Arthurdw/tesla-p4-shroud/output/cfd/base_rep/cfd_funnel_zfan.png

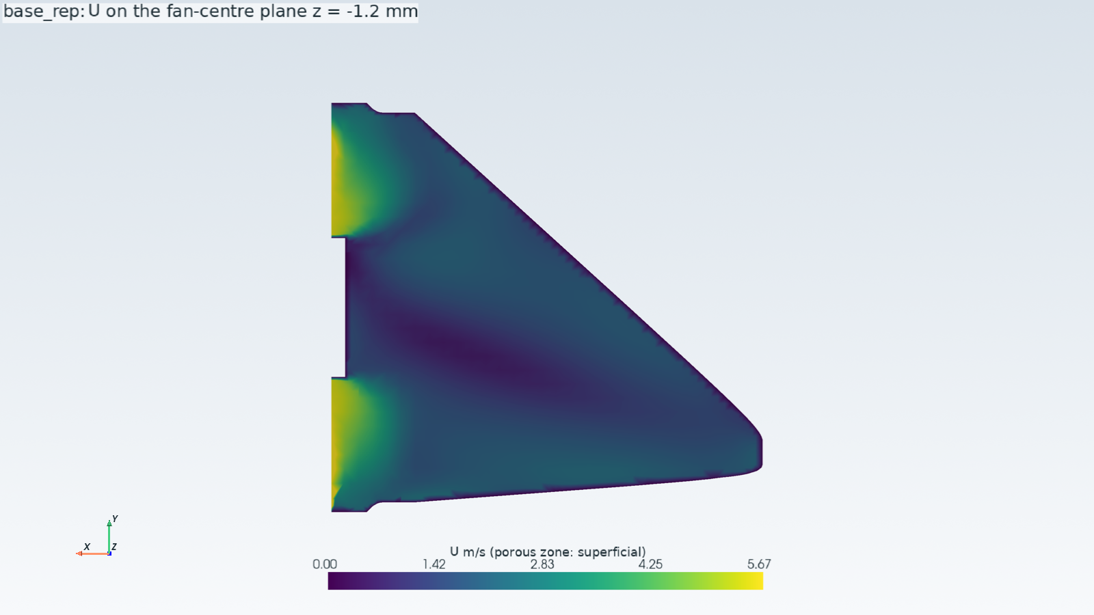
output/cfd/base_rep/cfd_funnel_zfan.png
