Arthurdw/tesla-p4-shroud/output/cfd/base_rep/cfd_plane_y.png

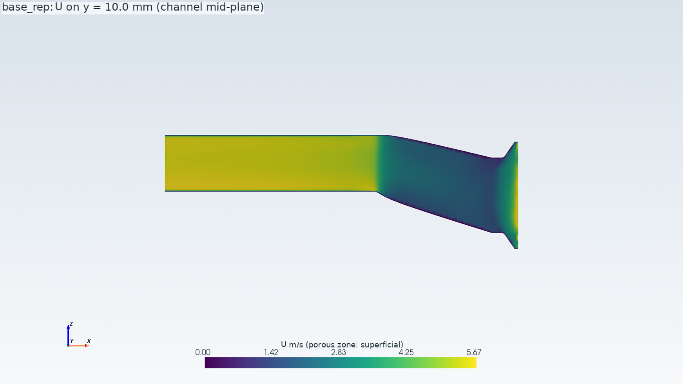
output/cfd/base_rep/cfd_plane_y.png
