Arthurdw/tesla-p4-shroud/output/cfd/final_c4/cfd_plane_y.png

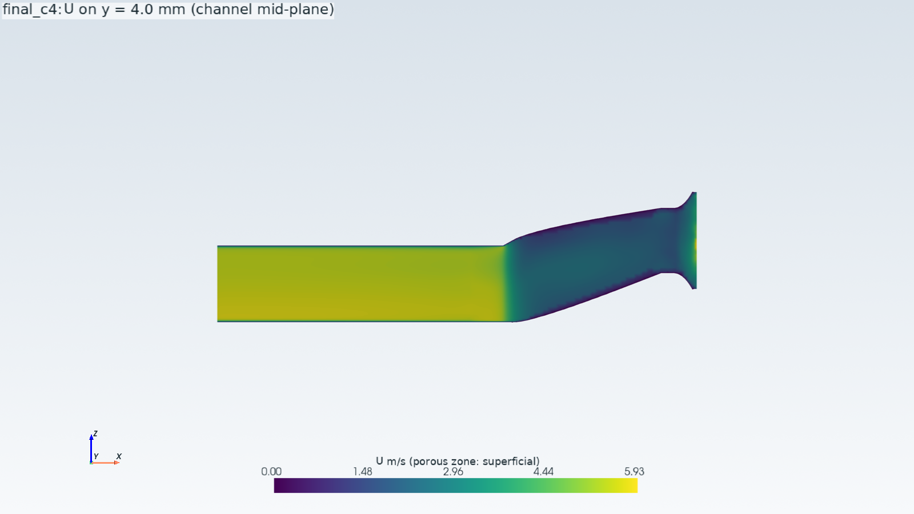
output/cfd/final_c4/cfd_plane_y.png
