Arthurdw/tesla-p4-shroud/output/cfd/hi_final_c4/cfd_funnel_zfan.png

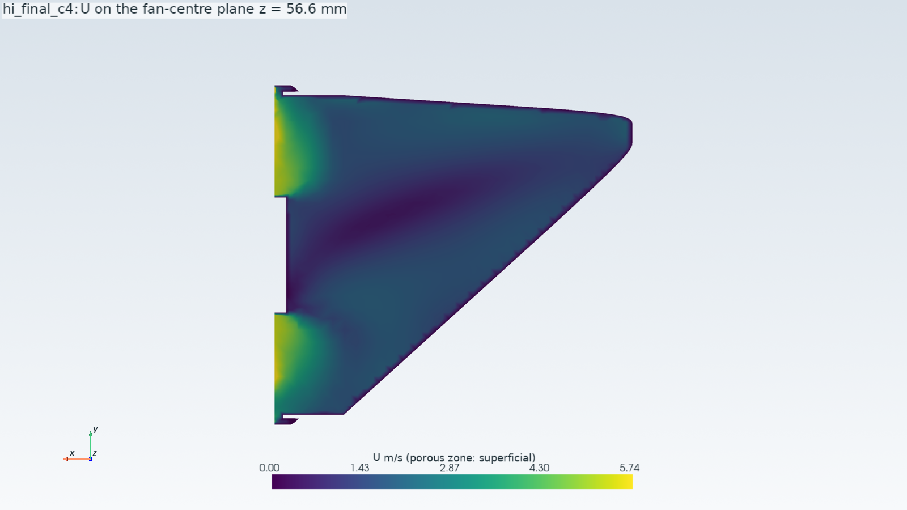
output/cfd/hi_final_c4/cfd_funnel_zfan.png
