Arthurdw/tesla-p4-shroud/output/cfd/hi_final_c4/cfd_plane_z.png

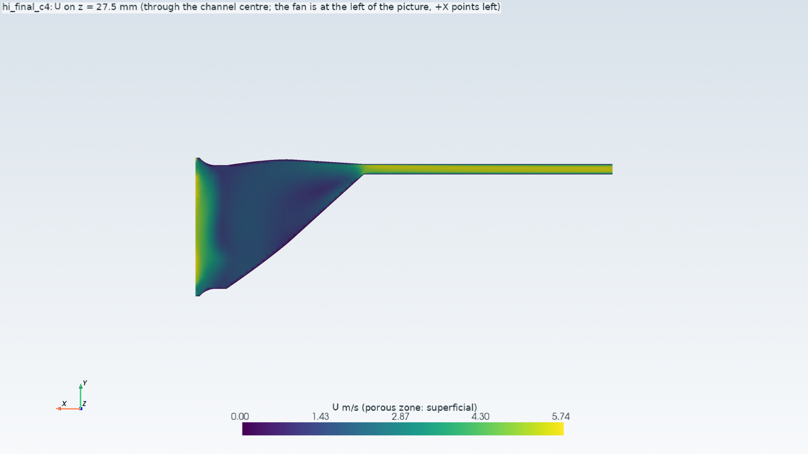
output/cfd/hi_final_c4/cfd_plane_z.png
