Arthurdw/tesla-p4-shroud/output/cfd/s_gap_2mm/cfd_pressure_x.png

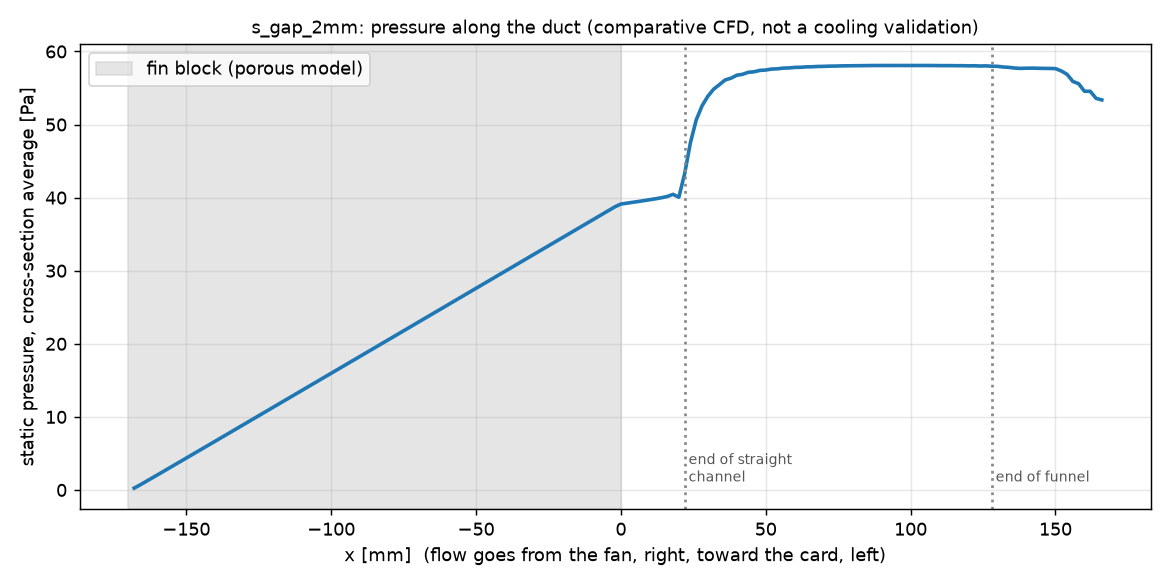
output/cfd/s_gap_2mm/cfd_pressure_x.png
