Arthurdw/tesla-p4-shroud/output/cfd/sens_diff50_c4/cfd_funnel_zfan.png

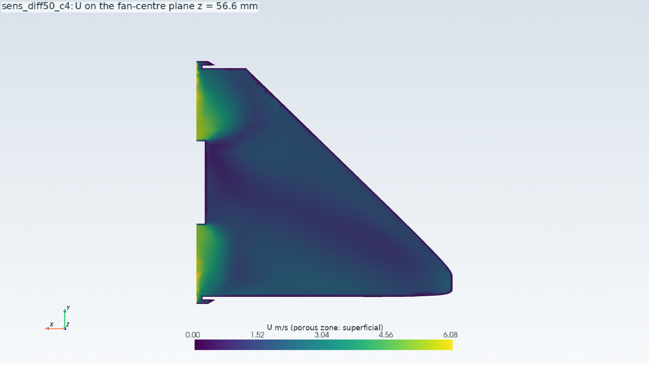
output/cfd/sens_diff50_c4/cfd_funnel_zfan.png
