Arthurdw/tesla-p4-shroud/output/cfd/sens_diff50_c4/cfd_plane_y.png

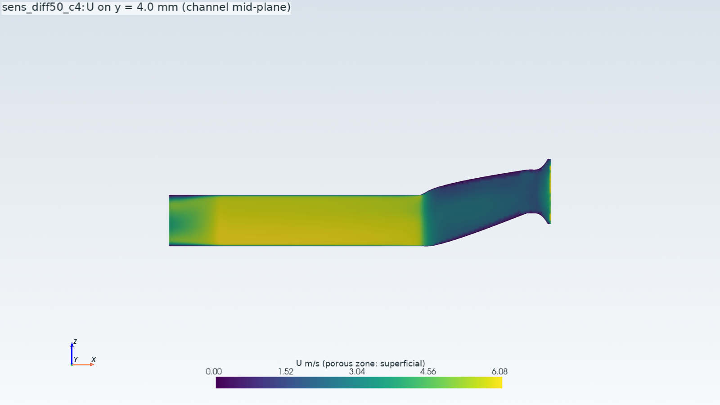
output/cfd/sens_diff50_c4/cfd_plane_y.png
