Arthurdw/tesla-p4-shroud/output/cfd/sens_diff50_c4/cfd_pressure_x.png

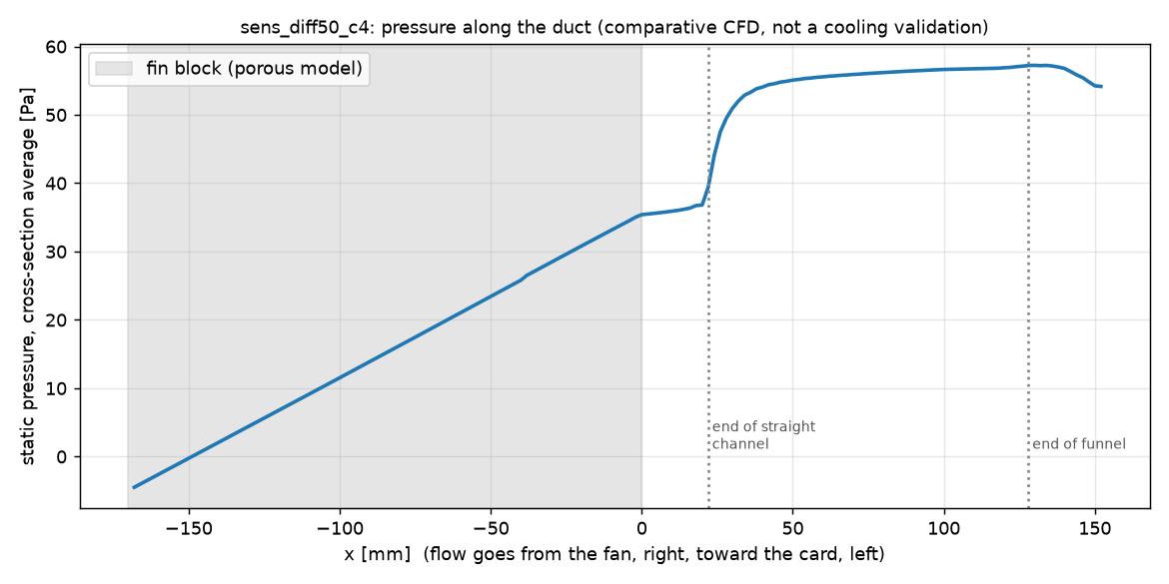
output/cfd/sens_diff50_c4/cfd_pressure_x.png
