Arthurdw/tesla-p4-shroud/output/cfd/short_t89_5k/cfd_plane_z.png

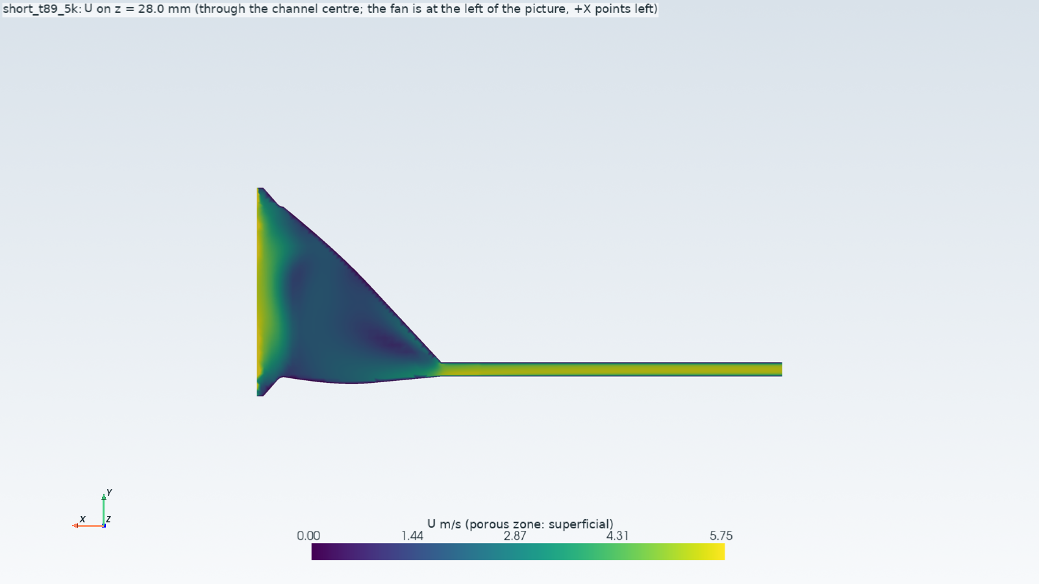
output/cfd/short_t89_5k/cfd_plane_z.png
