Arthurdw/tesla-p4-shroud/output/cfd/short_t89_5k/cfd_pressure_x.png

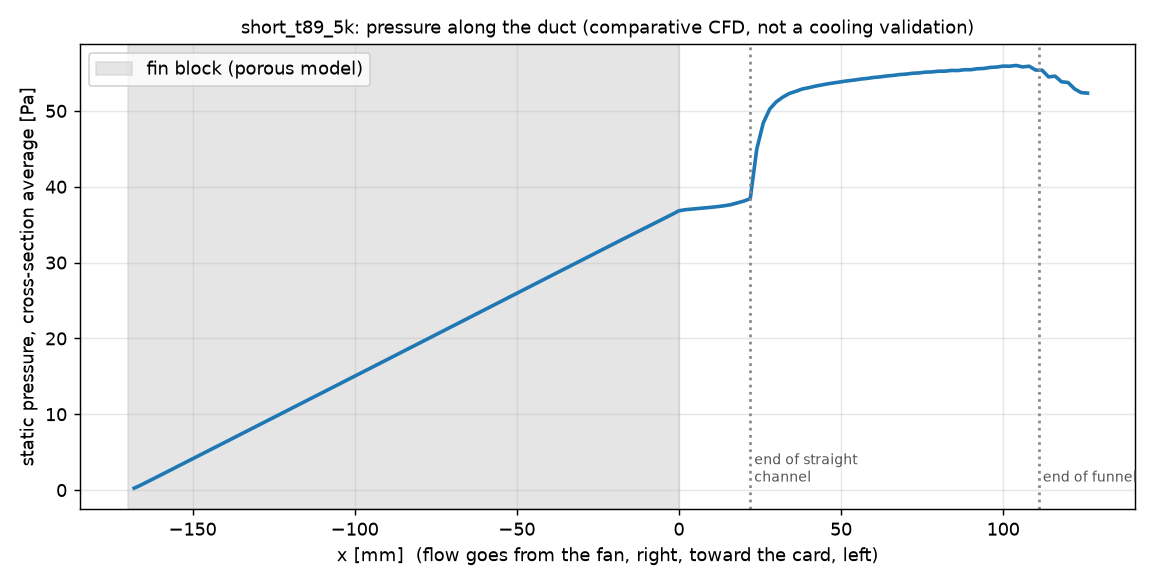
output/cfd/short_t89_5k/cfd_pressure_x.png
