Arthurdw/tesla-p4-shroud/output/cfd/spacer_t77_5k/cfd_funnel_zfan.png

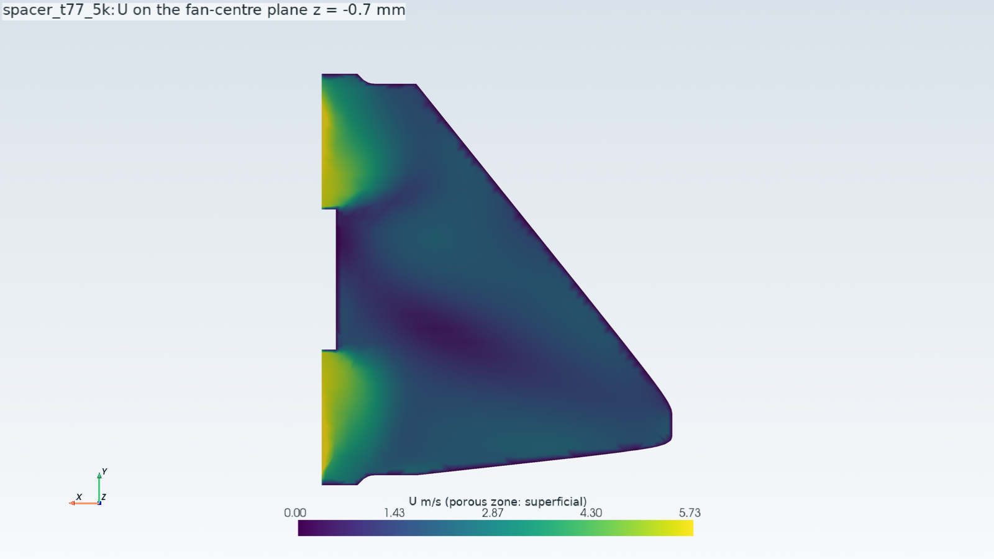
output/cfd/spacer_t77_5k/cfd_funnel_zfan.png
