Arthurdw/tesla-p4-shroud/output/preview_comb.png

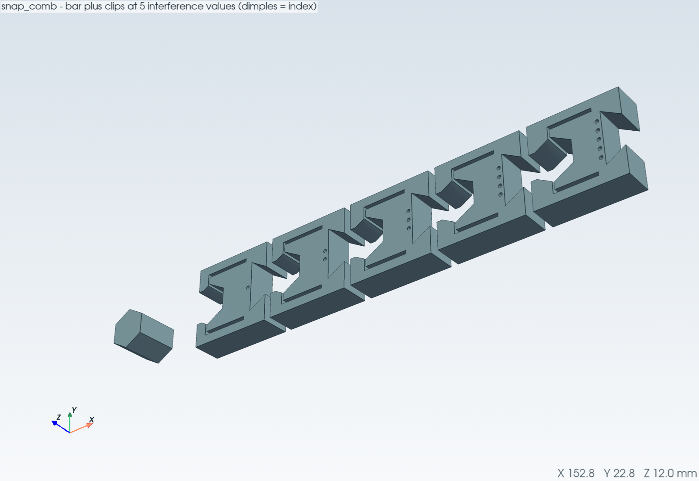
output/preview_comb.png
