Arthurdw/tesla-p4-shroud/output/preview_support_assy.png

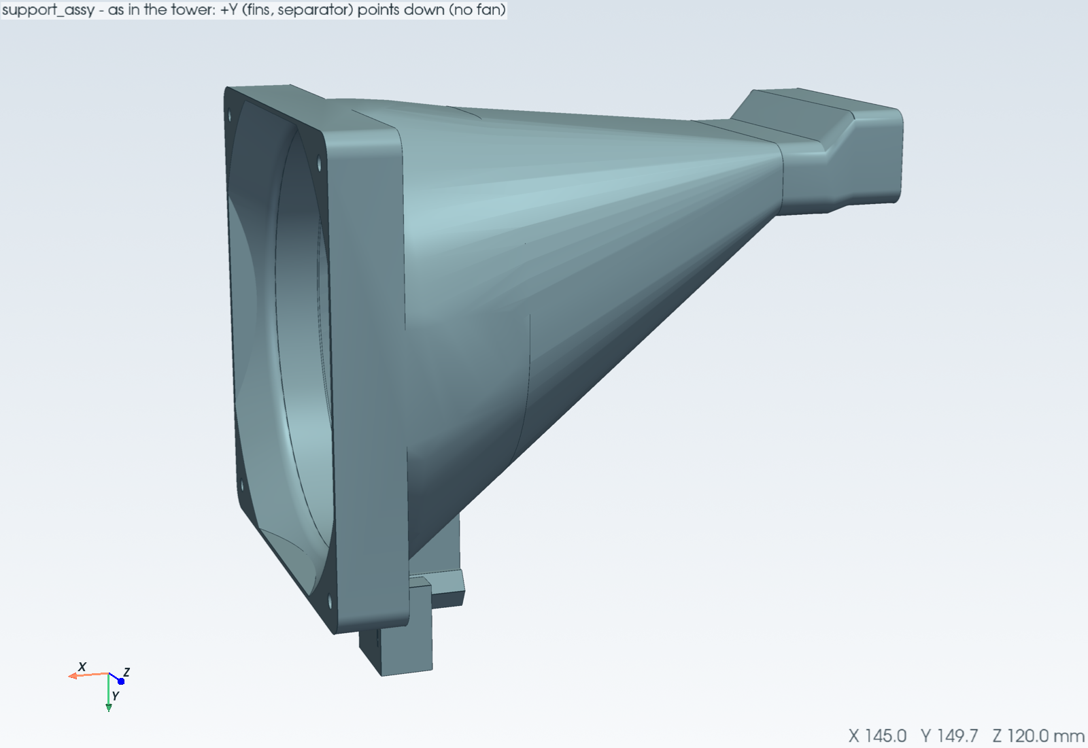
output/preview_support_assy.png
