Arthurdw/tesla-p4-shroud/output/cfd/fins/results.csv

name | t | model | u_gap | dp_total | dpdx | iters | converged | cells
t0.3_laminar_u0.4 | 0.3 | laminar | 0.4 | 1.2138539999999998 | 6.342240479999998 | 353 | True | 136488
t0.3_laminar_u3 | 0.3 | laminar | 3 | 14.415912 | 61.991958000000004 | 224 | True | 136488
t0.3_laminar_u5 | 0.3 | laminar | 5 | 29.215019999999996 | 120.6597324 | 215 | True | 136488
t0.3_laminar_u7 | 0.3 | laminar | 7 | 47.054387999999996 | 189.59086799999997 | 210 | True | 136488
t0.3_laminar_u9 | 0.3 | laminar | 9 | 67.515012 | 267.24042 | 209 | True | 136488
t0.3_kOmegaSST_u0.4 | 0.3 | kOmegaSST | 0.4 | 1.2142188 | 6.34270236 | 351 | True | 136488
t0.3_kOmegaSST_u3 | 0.3 | kOmegaSST | 3 | 13.761335999999998 | 59.867283599999986 | 226 | True | 136488
t0.3_kOmegaSST_u5 | 0.3 | kOmegaSST | 5 | 28.000812 | 120.86823599999998 | 203 | True | 136488
t0.3_kOmegaSST_u7 | 0.3 | kOmegaSST | 7 | 46.045752 | 205.98220799999999 | 196 | True | 136488
t0.3_kOmegaSST_u9 | 0.3 | kOmegaSST | 9 | 67.56991199999999 | 310.69404 | 194 | True | 136488
t0.8_laminar_u0.4 | 0.8 | laminar | 0.4 | 1.396866 | 7.4210982 | 400 | True | 142208
t0.8_laminar_u3 | 0.8 | laminar | 3 | 16.559376 | 68.8934196 | 279 | True | 142208
t0.8_laminar_u5 | 0.8 | laminar | 5 | 34.198644 | 132.665796 | 267 | True | 142208
t0.8_laminar_u7 | 0.8 | laminar | 7 | 56.090064 | 207.19656 | 254 | True | 142208
t0.8_laminar_u9 | 0.8 | laminar | 9 | 81.83809199999999 | 290.571612 | 260 | True | 142208
t0.8_kOmegaSST_u0.4 | 0.8 | kOmegaSST | 0.4 | 1.3971647999999999 | 7.4212519200000004 | 399 | True | 142208
t0.8_kOmegaSST_u3 | 0.8 | kOmegaSST | 3 | 15.608424 | 66.9587916 | 278 | True | 142208
t0.8_kOmegaSST_u5 | 0.8 | kOmegaSST | 5 | 31.756643999999998 | 134.06210399999998 | 269 | True | 142208
t0.8_kOmegaSST_u7 | 0.8 | kOmegaSST | 7 | 52.50809999999999 | 228.99971999999997 | 261 | True | 142208
t0.8_kOmegaSST_u9 | 0.8 | kOmegaSST | 9 | 77.717748 | 344.887212 | 262 | True | 142208
