Arthurdw/tesla-p4-shroud/output/preview_support_parts.png

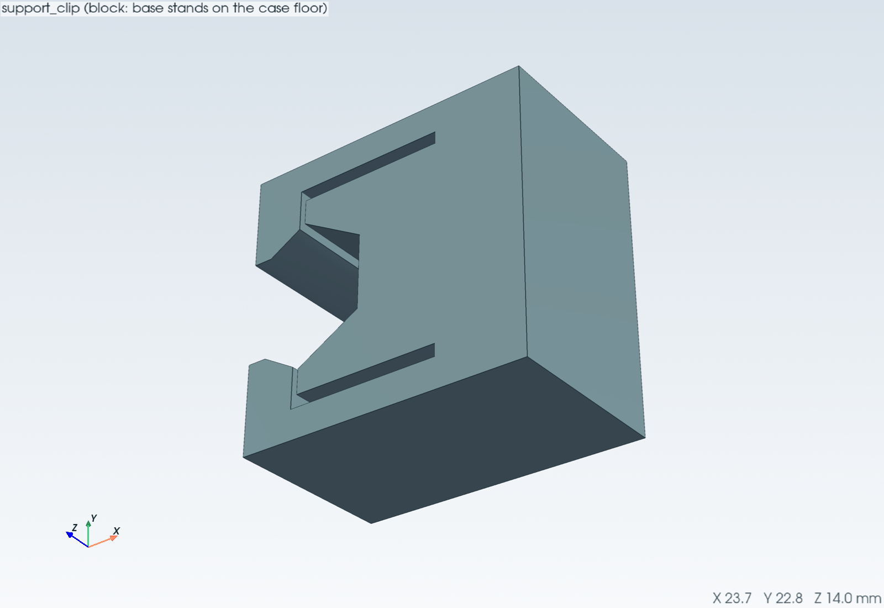
output/preview_support_parts.png
