Arthurdw/tesla-p4-shroud/output/support_assy.stl

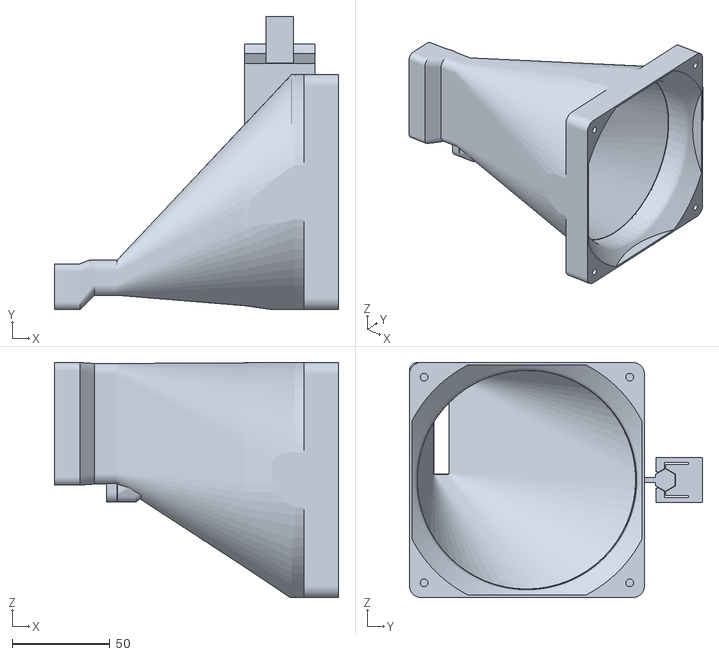
[picture p38: CAD file, 2026-10-28]
output/support_assy.stl
145.0 x 149.7 x 120.0
