Arthurdw/tesla-p4-shroud/output/spacer_print.3mf

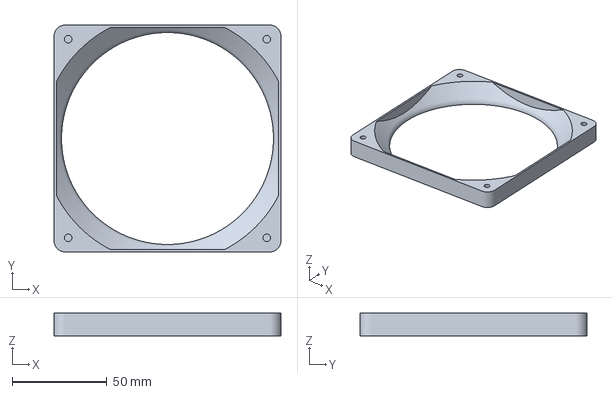
[picture p39: CAD file, 2026-10-28]
output/spacer_print.3mf
120.0 x 120.0 x 12.0 mm
