Arthurdw/tesla-p4-shroud/output/shroud_print.3mf

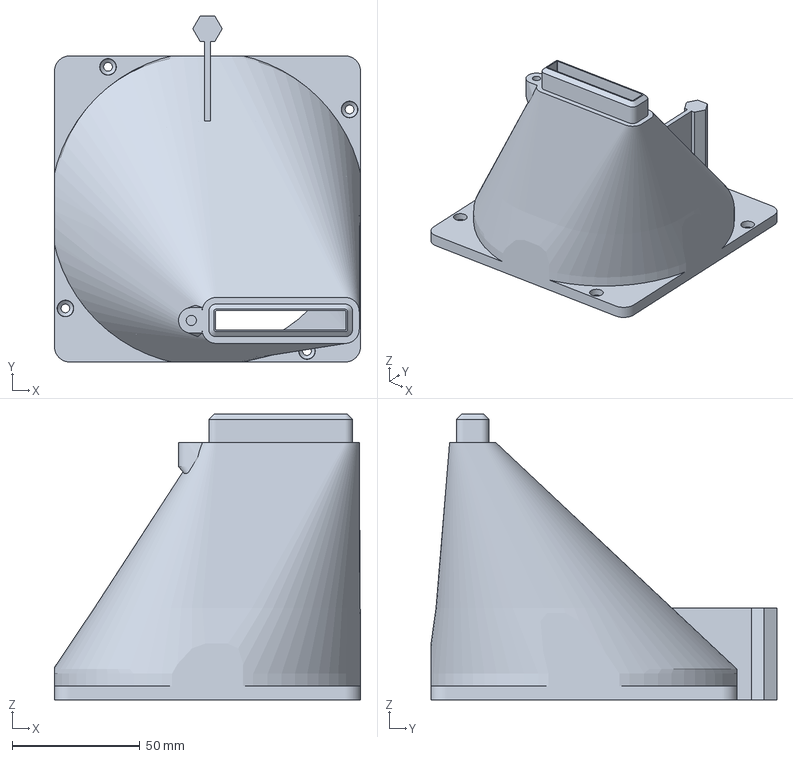
[picture p40: CAD file, 2026-10-28]
output/shroud_print.3mf
120.0 x 135.7 x 112.0 mm
