Arthurdw/tesla-p4-shroud/output/stator_layer.stl

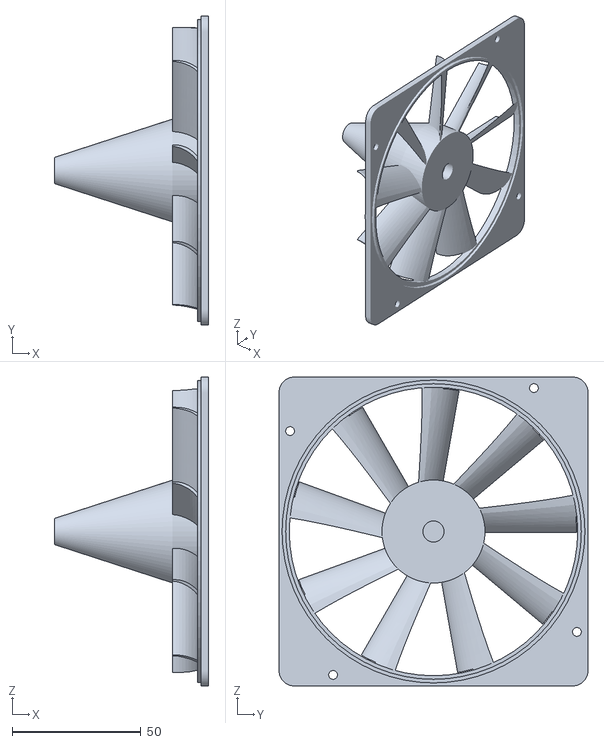
[picture p41: CAD file, 2026-10-28]
output/stator_layer.stl
60.0 x 120.0 x 120.0
