Arthurdw/tesla-p4-shroud/output/sleeve_print.3mf

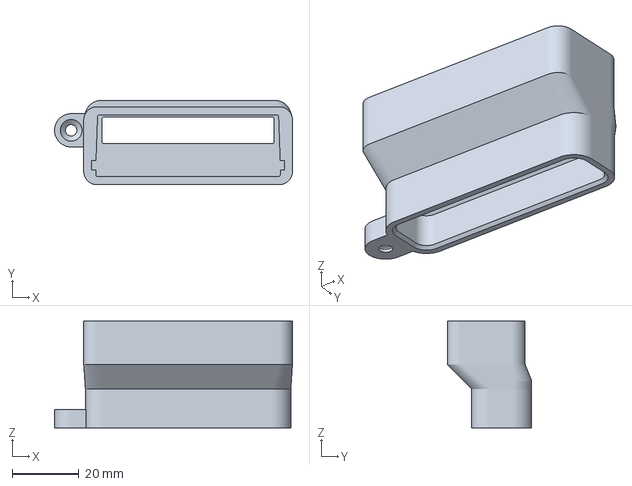
[picture p42: CAD file, 2026-10-28]
output/sleeve_print.3mf
71.3 x 25.3 x 32.0 mm
