Arthurdw/tesla-p4-shroud/output/fitcheck_fanface_d132.stl

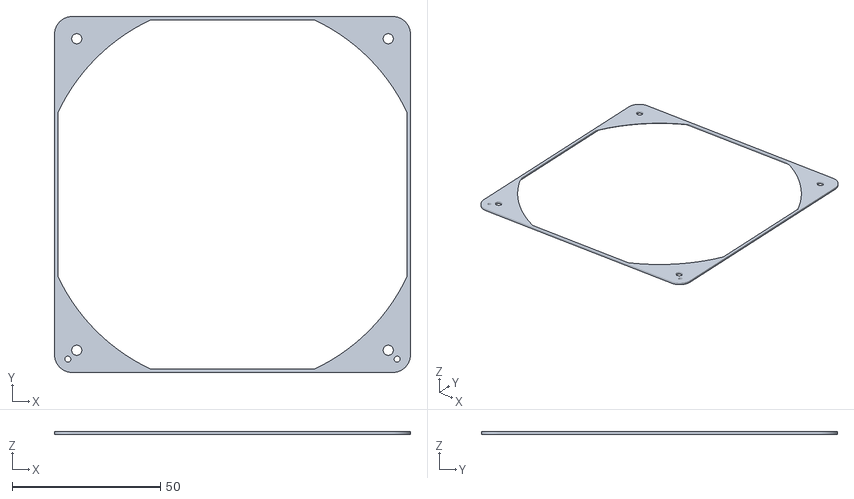
[picture p43: CAD file, 2026-10-28]
output/fitcheck_fanface_d132.stl
120.0 x 120.0 x 1.00
