Arthurdw/tesla-p4-shroud/output/fitcheck_mouth.3mf

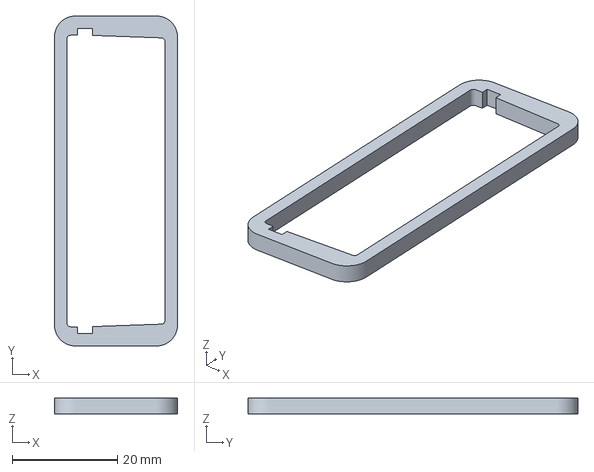
[picture p44: CAD file, 2026-10-28]
output/fitcheck_mouth.3mf
23.3 x 62.6 x 3.00 mm
