Arthurdw/tesla-p4-shroud/output/support_clip.stl

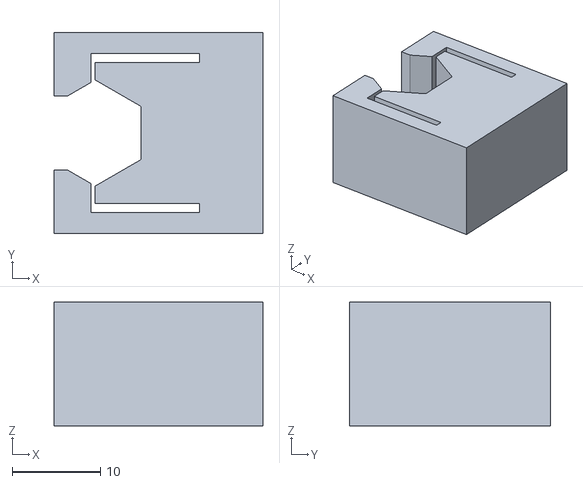
[picture p45: CAD file, 2026-10-28]
output/support_clip.stl
23.7 x 22.8 x 14.0
