Arthurdw/tesla-p4-shroud/output/fitcheck_fanface_d127.stl

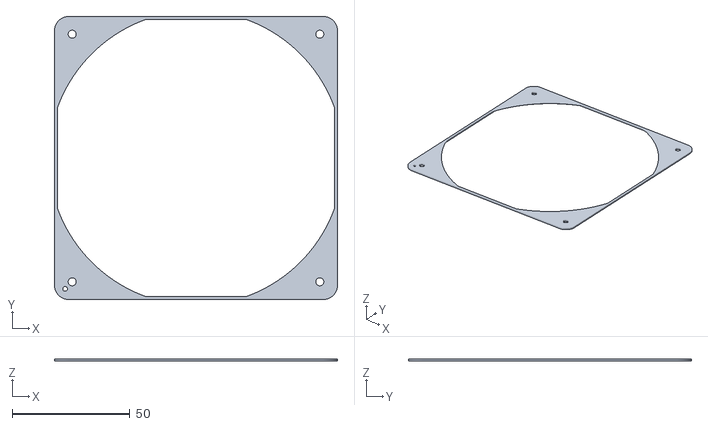
[picture p46: CAD file, 2026-10-28]
output/fitcheck_fanface_d127.stl
120.0 x 120.0 x 1.00
