Arthurdw/tesla-p4-shroud/output/stator_nose.stl

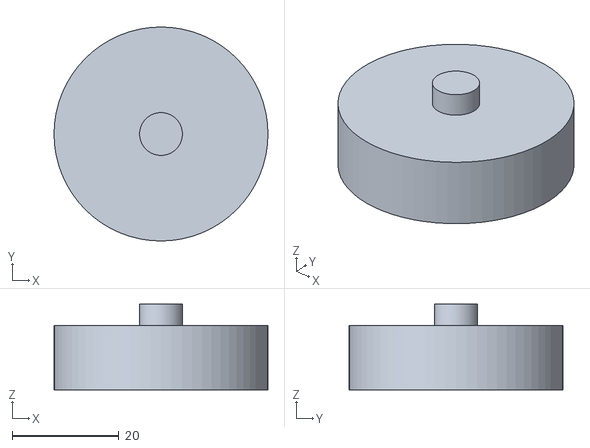
[picture p47: CAD file, 2026-10-28]
output/stator_nose.stl
40.0 x 40.0 x 16.0
