Arthurdw/tesla-p4-shroud/output/fitcheck_fanface_d137.stl

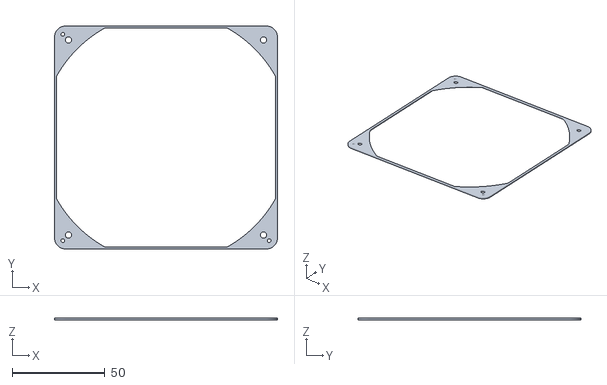
[picture p48: CAD file, 2026-10-28]
output/fitcheck_fanface_d137.stl
120.0 x 120.0 x 1.00
