Arthurdw/tesla-p4-shroud/output/fitcheck_interface.stl

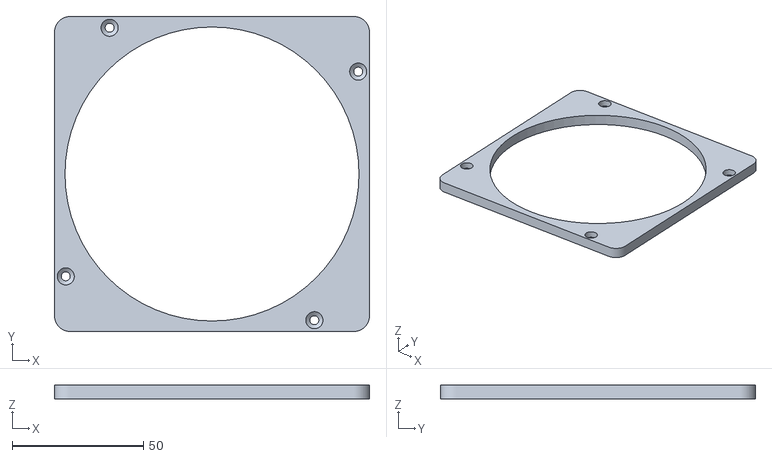
[picture p49: CAD file, 2026-10-28]
output/fitcheck_interface.stl
120.0 x 120.0 x 5.50
