Arthurdw/tesla-p4-shroud/output/seal_ring.stl

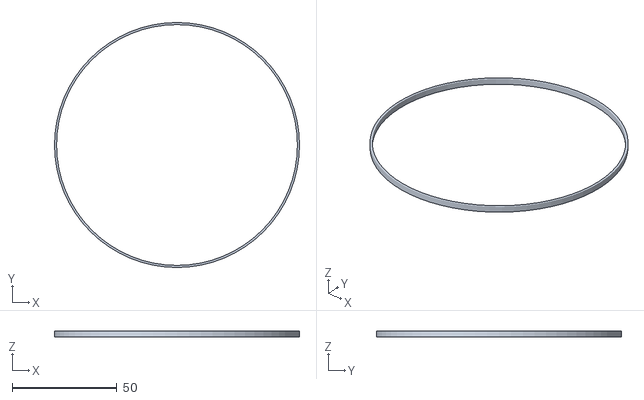
[picture p50: CAD file, 2026-10-28]
output/seal_ring.stl
117.2 x 117.2 x 2.80
