Arthurdw/tesla-p4-shroud/output/snap_comb.stl

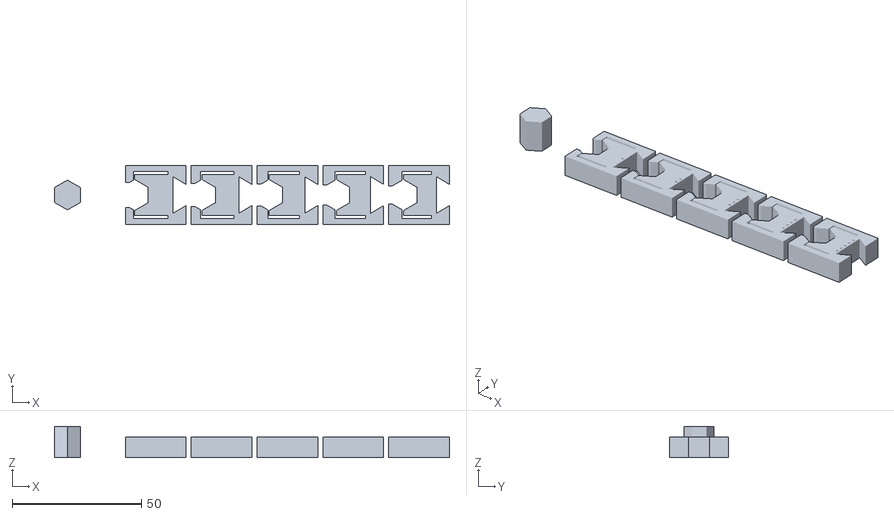
[picture p51: CAD file, 2026-10-24]
output/snap_comb.stl
152.8 x 22.8 x 12.0
