Arthurdw/tesla-p4-shroud/(list of files, cad)

Other CAD files:
output/spacer.stl
output/stator_layer_print.3mf
output/shroud.stl
output/fitcheck_fanface.stl
output/sleeve.stl
output/fitcheck_mouth.stl
output/shroud_print.stl
output/sleeve_print.stl
output/spacer_print.stl
output/stator_layer_print.stl
