Arthurdw/tesla-p4-shroud/output/cfd/final_c3/hand_params.txt

fan_p0=64.328 fan_qmax=0.05186111111111111 rpm=3000.0 fin_k=1.0 fin_dh=6.04666 fin_fre=14.951 fin_pitch=5.16 fin_t=0.3 hs_len=170.0 fan_stack=1 chan_h=8.0 chan_hz=51.6
