Arthurdw/tesla-p4-shroud/(commit log)

2026-10-24 begin: inital commit
    Parametric sleeve + funnel shroud for an NF-F12 iPPC-3000 on a passive
    Tesla P4, with optional spacer/stator modules, support clip/leg/foot,
    fit-check coupons, exported STL/3MF, preview renders, and the
    comparative OpenFOAM CFD setup and result summaries.
    Work in progress: not yet fit-tested beyond the sleeve slide fit, and
    cooling is unvalidated (check nvidia-smi under load).
    Claude-Session: https://claude.ai/code/session_01Jz4CjTa6RRgnJeEQJBihLE
    [cfd_params.txt, domain.scad, fitcheck_fanface.stl, fitcheck_fanface_d127.stl, fitcheck_fanface_d132.stl, fitcheck_fanface_d137.stl, fitcheck_interface.stl, fitcheck_mouth.3mf]
2026-10-24 feat: improvement
    [cfd_params.txt, fitcheck_fanface.stl, fitcheck_fanface_d127.stl, fitcheck_fanface_d132.stl, fitcheck_fanface_d137.stl, fitcheck_interface.stl, fitcheck_mouth.3mf, hand_params.txt]
2026-10-28 fix: have the width from in my case perfect
    [fitcheck_fanface.stl, fitcheck_fanface_d127.stl, fitcheck_fanface_d132.stl, fitcheck_fanface_d137.stl, fitcheck_interface.stl, fitcheck_mouth.3mf, params.scad, seal_ring.stl]
